MERTAYDIN46/EE463_HardwareProject-M.P.W.U-electronics-/README.md

# EE463_HardwareProject-M.P.W.U-electronics-
