MERTAYDIN46/EE463_HardwareProject-M.P.W.U-electronics-/Final report (2).docx

Thermal design:

Thermal design one of the most important considerations in the power electronic circuits because there a lot of power handling electronic components and unfortunately, these devices does not work at %100 efficiency. Therefore, some of the losses should be dissipated as heat through these components. However, these devices can not tolerate that much heat by itselves. Thus, additional mechanical parts should be integrated with them to ease the dissipation of the heat. Additionally, not just because the safety of the components, but also, performance and life-time of the components are mostly determined by thermal design so, it should be implemented for those reasons.

For our circuit, there are two parts that dissipate heat significantly, These are rectifier unit, and buck converter. Since we have one compact rectifier module and also diode and mosfet which form buck converter connected to same heatsink, two heatsinks are used totally.

while selecting heatsinks, not just driving at no load is considered but also robustness bonus is considered. Therefore, calculations are made for both requirements as follows.

Calculations:

for the first, the heatsink for buck converter is calculated

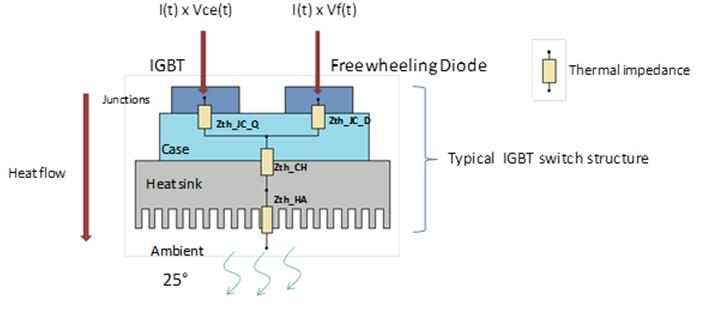
[picture p1: figure]

figure??: thermic lumped parameter model of the buck converter.

- First we assume the thermal contact between the heatsink and component are neglible so, we neglect that part.
- Secondly, we should calculate total power loss to select the suitable heatsink.

For that purpose, we should look back to datasheet of the diode and IGBT to obtain the pararameters for both conduction losses and switching losses.

firstly , we use DHG30I600PA diode and its parameters are as follows:

(*) Vfo=1.17V.

(**) rF=32 mΩ.

And for the Switching losses,

Ps=Qr×Vr×fs (we already know the fs=500Hz and Vr =200V at most)

We just need to find Qr from following graph.

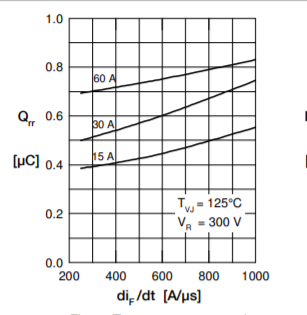
[picture p2: figure]

Figure?? Qr vs dif/dt from datasheet.

From above figure we Assume Qr as 0.3 uA at worst situation because the current that pass through the diode never exceeds the 10A.

So, we can insert those values to the equations,

Pcd= (1.17 +10 × 0.032) × 10 ≈15 Watt (we assume at most diode conduct 10 A which is still lover than rated operation of the project

Psd=0.3 ×200×500×10 ^(-6) ≈ 0 (since frequency is low it is normal)

Psd+Pcd=15 Watt at total contribution from diode.

Now we can calculate the losses for the IGBT.

For the conduction losses of IGBT,

Vce=1.6 V (collector emitter sat. voltage)

If=10 A ( for a safety margin. normally it depends on duty cycle)

Pic= 16 Watt .

For the Switching losses, we should obtain the energy required for opening and closing.

We choose the “IGW30N60T” IGBT and from its datasheet, ETOTAL=1.8 mJ

the frequency of operation is around 500Hz and that energy will be given and taken in one interval of operation. Therefore, we should multiply fS with the ETOTAL to find switching loss.

Pis=fS ×Etotal≈1 watt (it expected since frequency is so low)

Therefore, total contribution from IGBT is 17 watt.

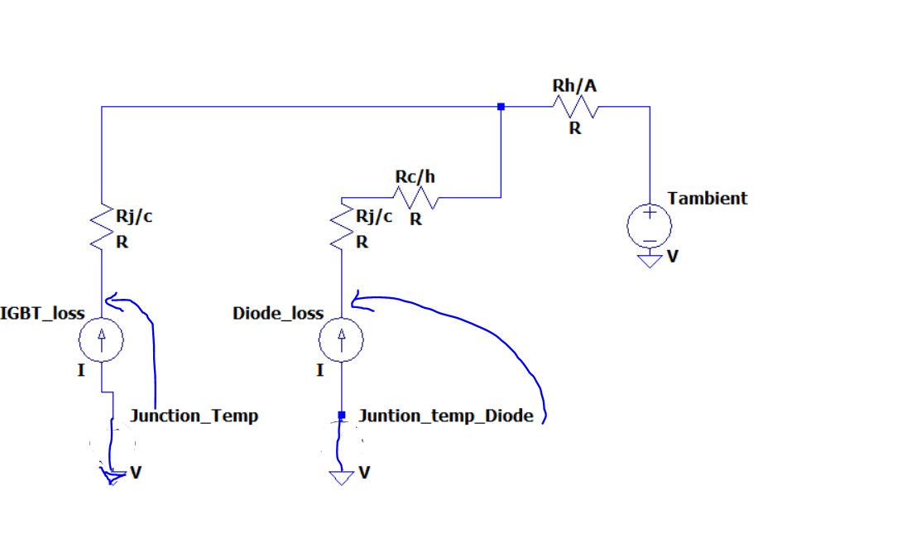
[picture p3: figure]

Figure??: detailed lumped model of thermal design.

- Thirdly, we should find the thermal resistances from the datasheets and guessing a reasonable heatsink value from these results.

Rj/c(diode)=0.7 C/W , Rc/H(diode) =0.5 C/W Rtotal=1.2C/W

Rj/c(IGBT)=0.8 C/W

if we assume heatsink has 1.0 C/W thermal resistance then the junction temperatures will become as below:

Tj(diode)=25+15 ×1.2+ 32 × 1=75 C.

Tj(IGBT)=25+17 × 0.8+32 × 1=70.6 C.

These are far less values that the maximum operating junction temperature which is 175 C degrees so, we select a heatsink which has 0.9 C/W thermal resistance to realize the that idea.

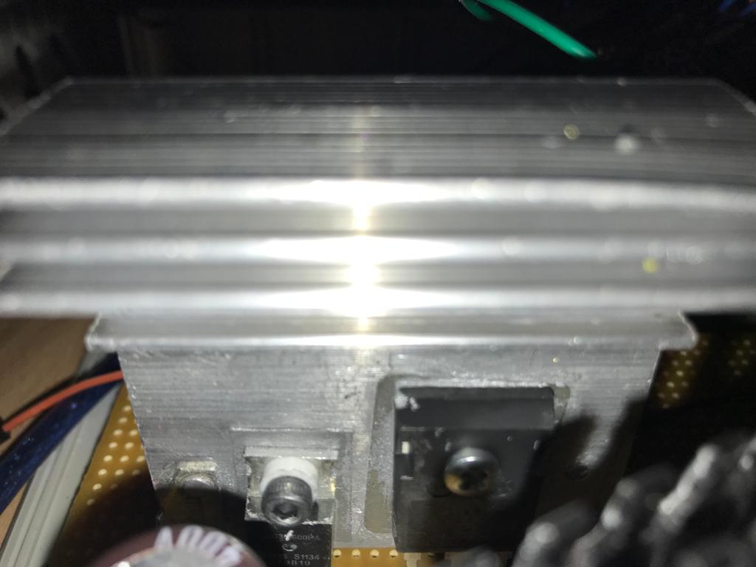
[picture p4: figure]

Figure??: Resultant hardware configuration of thermal design (for buck converter)

For the Second, we will calculate the heatsink required for the Three-phase full bridge rectifier,

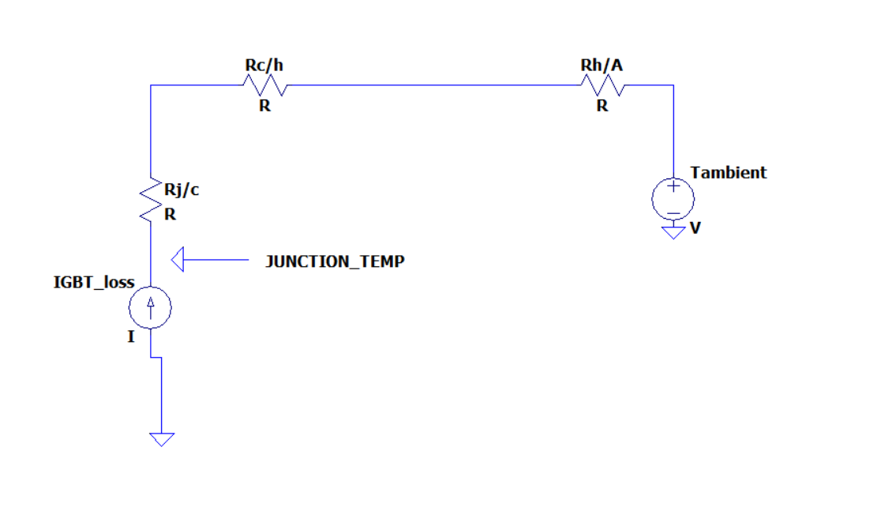
[picture p5: figure]

Figure:?? the detailed lumped model of the bridge module.

So, Again we should calculate the losses and applying the same procedures above for the selecting a suitable heatsink.

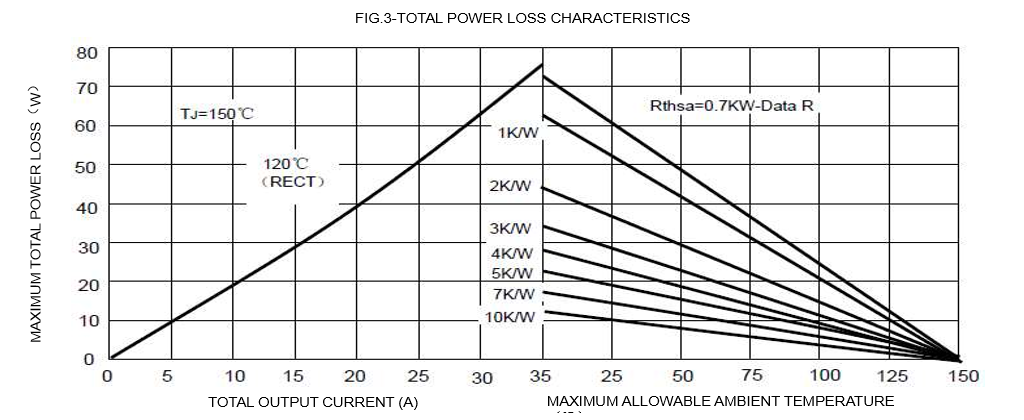
[picture p6: figure]

Figure??: power loss characteristic of the bridge module. (from datasheet)

Since we have a bridge module rather than six single diodes, accessing the datasheet of the diodes inside of the module is not possible. In datasheet provided for complete module includes some general power loss characteristic as in the figure above. this curve gives the maximum power loss therefore, it will be safe to use it although it may results with unnecessarily large heatsink.

Ploss= 20 Watt (at 10A output).

So, it is now time to find thermal parameters from the same datasheet.

Rj/c=1.16 C/W.

Rc/h=0.2 C/W.

So, we try with a 1.8C/W heatsink and result will be:

Tj=(1.16+0.2+1.8) × 20=88 C

So, it is again relatively safe for the operation of this project.

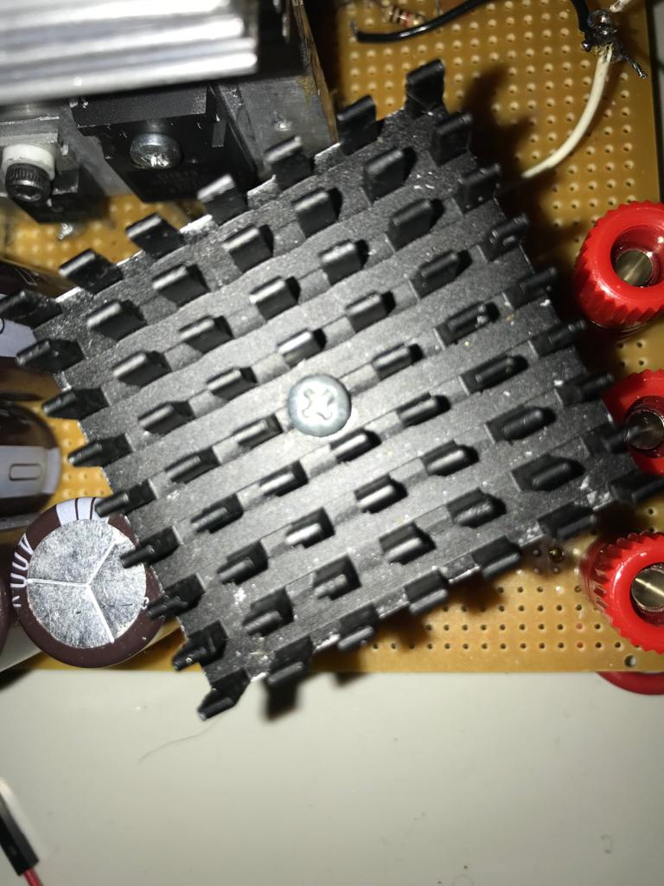
[picture p7: figure]

Figure:?? the heatsink for the full bridge rectifier.

Test results for the Thermal design

We have tested our circuit with constant R-L load. The current changes approximately in the range of 3A-4A. we take the data for the initial conditions and we start our driver circuit. After adjusting the duty cycle to obtain constant average current we simply record the thermal camera values at some interval.

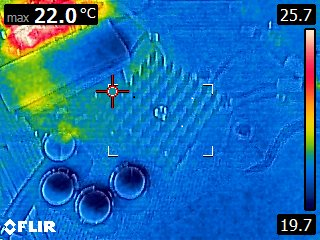
[picture p8: figure]

Figure??: data taken from the initial condition.

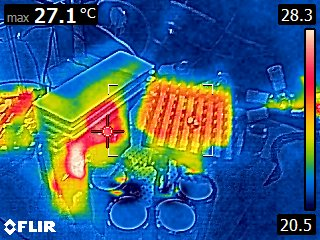
[picture p9: figure]

Figure??: thermal data

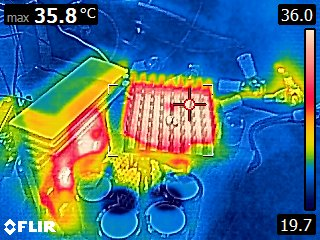
[picture p10: figure]

Figure??: thermal data

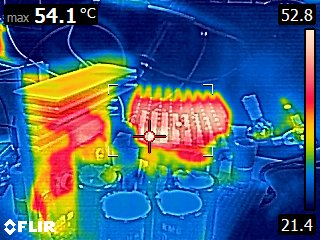
[picture p11: figure]

Figure??: thermal data at near the steady-state

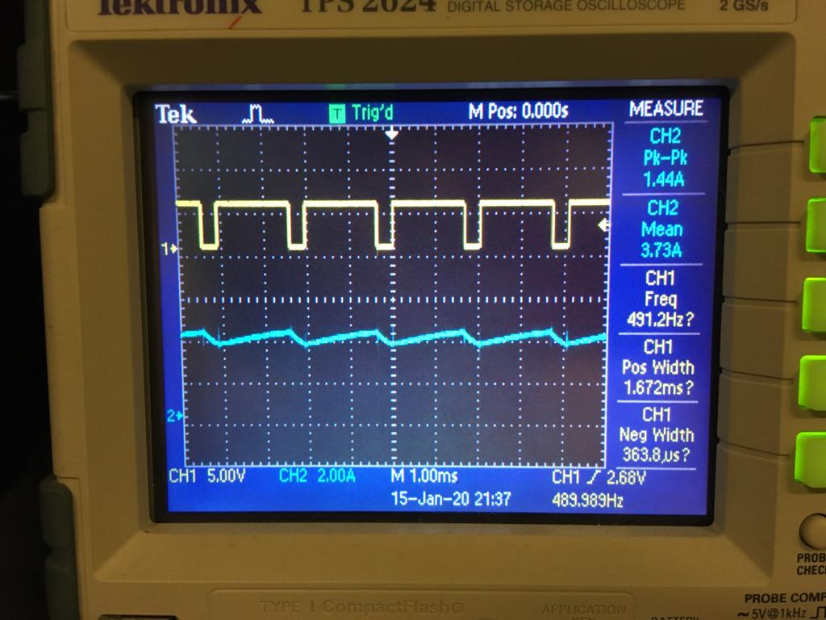
[picture p12: figure]

Figure??: Testing conditions.

Final Comment: The thermal design is calculated for the 10 ampere input current with %100 duty cycle case however test is done with approximately 4 ampere output current and since duty cycle is not %100 mosfet and diode currents are probably lower therefore it is normal to have lower temperatures for testing condition and to conclude our design and test results are correlated and it shows its success.
