MERTAYDIN46/EE463_HardwareProject-M.P.W.U-electronics-/Simulation Drafts/First Draft-Three Phase and Buck converter/First assumption.asc

C1: cap; 400µF
C2: cap; 22µ
D1: diode
D2: diode
D3: diode
D4: diode
D5: diode
D6: diode
L2: ind; 0.2
M1: nmos; R6020PNJ
M2: nmos; R6020PNJ
M3: nmos; R6020PNJ
M4: nmos; R6020PNJ
M6: nmos; R6020PNJ
R1: res; 0.8
R2: res; 1k
R3: res; 0.001
R4: res; 1k
R5: res; 1k
R6: res; 1k
R7: res; 0.1m
R8: res; 0.1m
R9: res; 0.1m
R10: res; 0.1m
R11: res; 10
R12: res; 22
R14: res; 1k
V1: voltage; SINE(0 325 50 0 0 120)
V2: voltage; SINE(0 325 50 0 0 -120)
V3: voltage; SINE(0 325 50 -240)
V4: voltage; PULSE(0 5 0 0.1m 0.1m 0.08)
V6: voltage; PULSE(0 5 0 0.1m 0.1m 0.0005 0.001 80)
V7: voltage; PULSE(0 5 0.09 0.1m 0.1m 0.0005 0.001)
V8: voltage; PULSE(0 5 0.09 0.1m 0.1m 0.08 6)
V9: voltage; PULSE(5 0 0 0.1m 0.1m 0.08 0.09)
Named nets: 0
.tran 0 0.16 0.01 uic
