MERTAYDIN46/EE463_HardwareProject-M.P.W.U-electronics-/(commit log)

2019-11-26 İnductor changed in Motor side
    Since Motor acts like a big RL circuit I move inductor to motor side.
2019-12-13 Shaft own torque is calculated in terms of efficiency and added to model
